exclamationMarek/skeuomorphicer_candle/README.md

# Skeuomorphicer Candle
thumbnail_candle
A more skeuomorphic LED candle, one that you turn on with a flame, and off with a blow, like a real candle!
Super simple design with no microcontrollers, op-amps nor any other integrated circuits. Just one transistor, one thermistor and a couple of passives.

As seen on youtube, here: [https://www.youtube.com/watch?v=r8O8MNvkZiY](https://www.youtube.com/watch?v=r8O8MNvkZiY)

# How it works
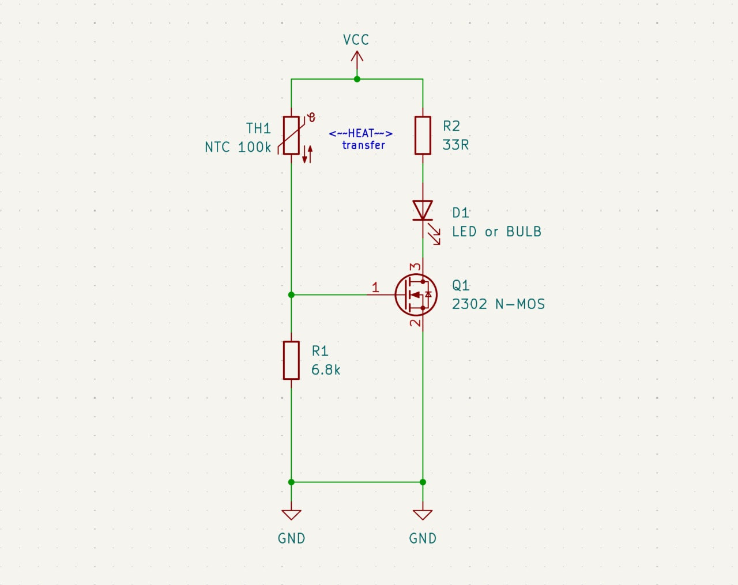
[picture p1: images/simplified_schematic.jpg]

* Heating the NTC thermistor makes its resistance drop, which increases the voltage on the MOSFET gate and turns on the bulb
* The current limiting R2 resistor gets hot
* The PCB is carefully designed to thermally connect R2 to the NTC
* Heat from R2 makes the NTC hot, so it stays hot even when the flame is removed
* This keeps the candle on
* Once you blow on the PCB, the heat is removed, breaking the cycle and turning off the light
* Yes, the schematic looks like a candle

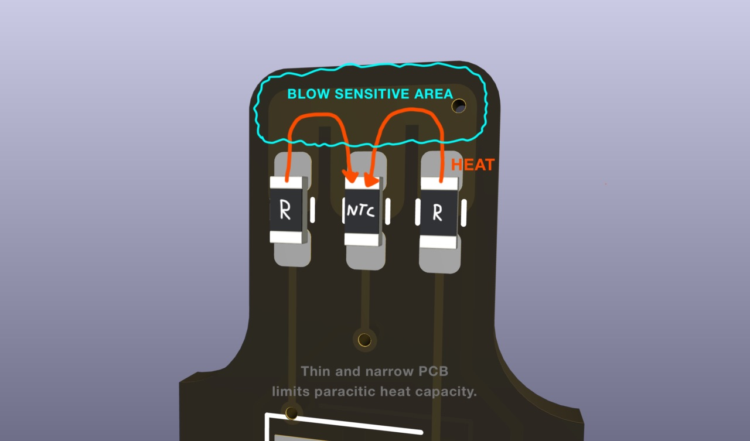
[picture p2: images/wick_design.jpg]

* The current limiting (and heat producing) resistor is doubled, to surround the NTC on both sides
* They also share an electrical connection with the NTC - the VCC node (on top)
* That VCC copper connection is used to transfer heat from the resistors to the NTC
* But also, is wide and exposed to being blown at
* This is a finicky design challenge that required iterative fine tuning
* The current implementation works best with about 0.1W (total) dissipated on the heating resistors, which keeps the NTC at about 55°C
* Testd on a 1.0mm 2-layer PCB with 35um copper foil. Tested with black solder mask (it might make a difference?)

Note that this is the simplified schematic that omits the power supply. In real application, the varying voltage of batteries causes the circuit to be unreliable. With a full battery, the NTC runs too hot, making the candle difficult to blow out, and with a low battery it runs too cool, turning itself off unprompted. To fix this, the recommended design adds a voltage regulator (boost converter) to keep VCC stable and the candle reliable.

# PCB design available in 4 variants:
## [Minimal](Skeuomorphic_candle_minimal)
* Designed for 1.5V mini light bulb and 2xAA batteries
* Very low component count
* Does not work with LEDs!
* No ICs. Just 1 NMOS, 1 NTC and some resistors
* If you want the simplest skeuomorphicer candle, use this PCB.
* Alternatively, use with external 3.3V regulated supply

## [Basic - recommended](Skeuomorphic_candle_basic)
* Works great with a mini light bulb and OK-ish with LEDs
* Supports various batteries
* Low component count, but requires power regulator IC
* If you want to make a resonably well working skeuomorphicer candle, use this PCB

## [Custom](Skeuomorphic_candle_custom)
* PCB with extra footprints for implementation flexibility
* Can be configured as either the "Minimal" or "Basic" variant
* Can be configured as bulb + LEDs
* LED brightness can be adjusted, while maintaining reliable flame detection
* Has test points
* If you want to experiment with the design, use this PCB

## [Digital](Skeuomorphic_candle_digital)
* EWWWW digital microcontroller!
* 32bits?! For like one 'if' statement?!
* 2KB of RAM?! You can fly to the bloody moon on 2KB of RAM!
* If you're one of those futuristic cyberpunk chooms, use this PCB. I will try not to cry.

Detailed configuration and assembly instructions are in each PCB variant folder.

# License
This project is published under the [Creative Commons Attribution-NonCommercial 4.0 License](https://creativecommons.org/licenses/by-nc/4.0/deed.en)

Full text in license.txt

A commertial use license may be provided upon request
