exclamationMarek/skeuomorphicer_candle/Skeuomorphic_candle_custom/README.md

# Custom Skeuomorphicer Candle
For when you want to experiment with the design

# UNTESTED!
As of releasing this repo, this PCB design is NOT TESTED. It might be all wrong.
