exclamationMarek/skeuomorphicer_candle/Skeuomorphic_candle_minimal/Skeuomorphic_candle_minimal.kicad_pcb

## KiCad design Skeuomorphic_candle_minimal/Skeuomorphic_candle_minimal.kicad_pcb (2026-10-23)

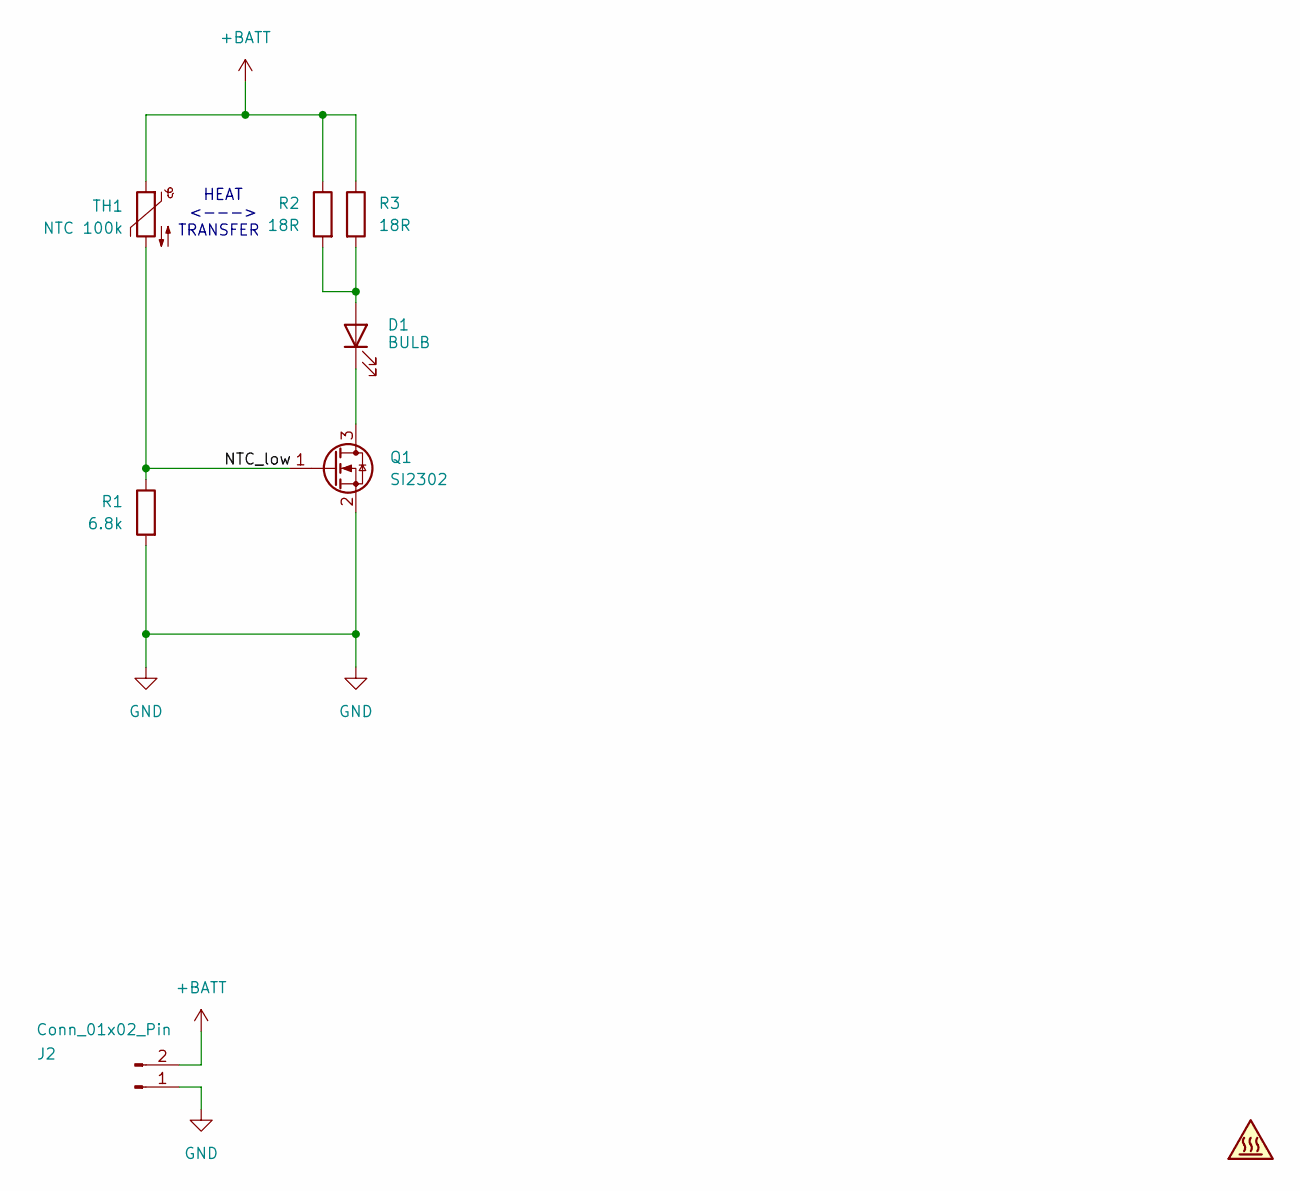
[picture p3: schematic Skeuomorphic_candle_minimal.kicad_sch, Skeuomorphicer Candle Minimal]

Parts:
D1: BULB; Mini_bulb_flat
J2: Conn_01x02_Pin; PinHeader_1x02_P2.54mm_Vertical
LOGO1: Logo; Skeuomorphicer_candle_logo
Q1: SI2302; SOT-23-handsoldering-smaller
R1: 6.8k; R_0603_1608Metric_Pad0.98x0.95mm_HandSolder
R2, R3: 18R; R_0603_1608Metric_Pad0.98x0.95mm_HandSolder
TH1: NTC 100k; R_0603_1608Metric_Pad0.98x0.95mm_HandSolder

Connections:
+BATT: J2.2, R2.1, R3.1, TH1.1
/NTC_low: Q1.1 (G), R1.1, TH1.2
GND: J2.1, Q1.2 (S), R1.2
unnamed: D1.2 (A), R2.2, R3.2
unnamed: D1.1 (K), Q1.3 (D)

Notes on the sheet:
HEAT <---> TRANSFER

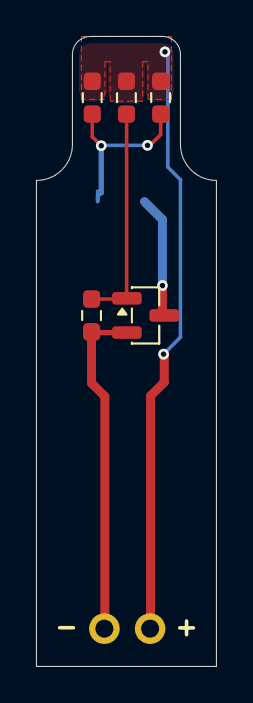
[picture p4: board Skeuomorphic_candle_minimal.kicad_pcb from above]

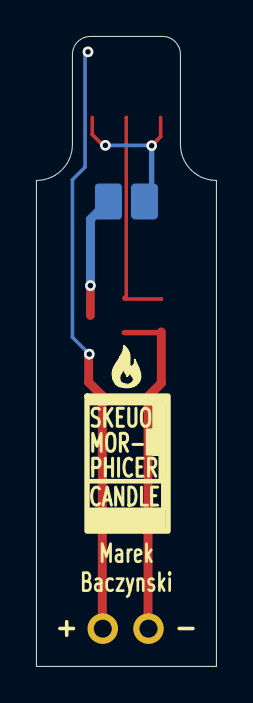
[picture p5: board Skeuomorphic_candle_minimal.kicad_pcb from below]

Board: 2 copper layers, 10.0 x 35.0 mm, 8 parts (2 on the bottom side), 5 nets.
