exclamationMarek/skeuomorphicer_candle/Skeuomorphic_candle_digital/Skeuomorphic_candle_digital.kicad_pcb

## KiCad design Skeuomorphic_candle_digital/Skeuomorphic_candle_digital.kicad_pcb (2026-10-23)

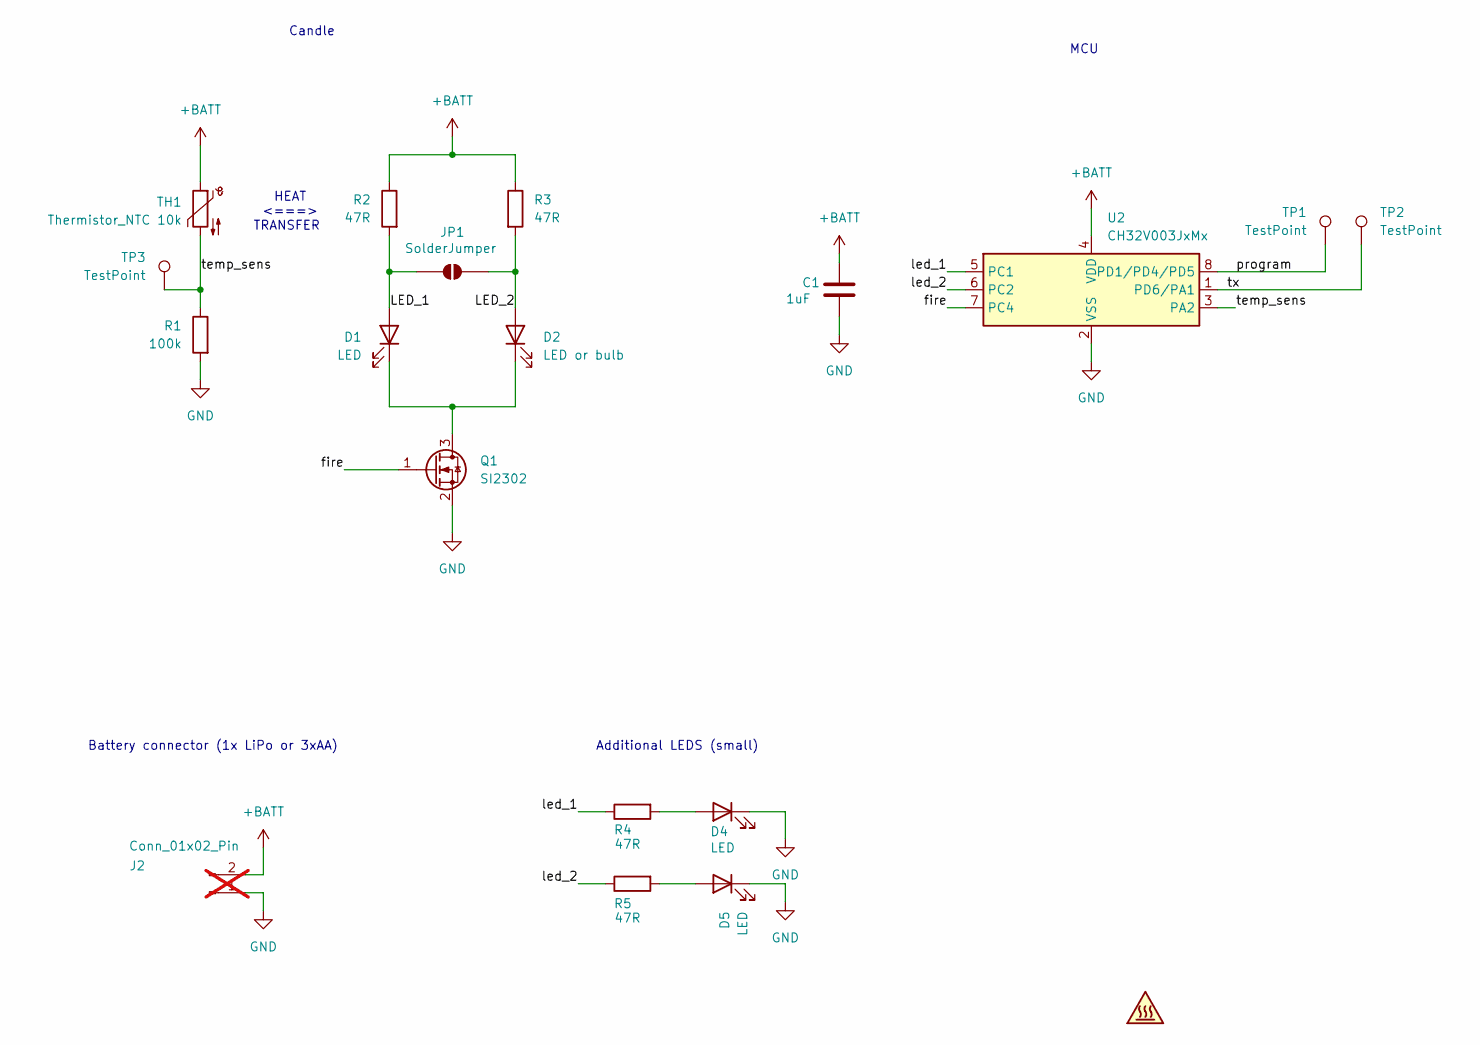
[picture p6: schematic Skeuomorphic_candle_digital.kicad_sch, Skeuomorphicer Candle - Digital]

Parts:
C1: 1uF; C_0603_1608Metric_Pad1.08x0.95mm_HandSolder
D1: LED; LED_PLCC_2835_Handsoldering
D2: LED or bulb; LED_PLCC_2835_Handsoldering
D4, D5: LED; LED_0603_1608Metric_Pad1.05x0.95mm_HandSolder
J2: Conn_01x02_Pin; PinHeader_1x02_P2.54mm_Vertical; not fitted
JP1: SolderJumper; SolderJumper-2_P1.3mm_Open_RoundedPad1.0x1.5mm
LOGO1: Logo; Skeuomorphicer_candle_logo
Q1: SI2302; SOT-23-handsoldering-smaller
R1: 100k; R_0603_1608Metric_Pad0.98x0.95mm_HandSolder
R2, R3, R4, R5: 47R; R_0603_1608Metric_Pad0.98x0.95mm_HandSolder
TH1: Thermistor_NTC 10k; R_0603_1608Metric_Pad0.98x0.95mm_HandSolder
TP1, TP2, TP3: TestPoint; TestPoint_Pad_D1.0mm
U2: CH32V003JxMx; JEITA_SOIC-8_3.9x4.9mm_P1.27mm

Connections:
+BATT: C1.1, J2.2, R2.1, R3.1, TH1.1, U2.4 (VDD)
/LED_1: D1.2 (A), JP1.1 (A), R2.2
/LED_2: D2.2 (A), JP1.2 (B), R3.2
/fire: Q1.1 (G), U2.7 (PC4)
/led_1: R4.1, U2.5 (PC1)
/led_2: R5.1, U2.6 (PC2)
/program: TP1.1 (1_1), U2.8 (PD1/PD4/PD5)
/temp_sens: R1.1, TH1.2, TP3.1 (1_1), U2.3 (PA2)
/tx: TP2.1 (1_1), U2.1 (PD6/PA1)
GND: C1.2, D4.1 (K), D5.1 (K), J2.1, Q1.2 (S), R1.2, U2.2 (VSS)
unnamed: D1.1 (K), D2.1 (K), Q1.3 (D)
unnamed: D4.2 (A), R4.2
unnamed: D5.2 (A), R5.2

Notes on the sheet:
MCU
Battery connector (1x LiPo or 3xAA)
HEAT <===> TRANSFER
Additional LEDS (small)
Candle

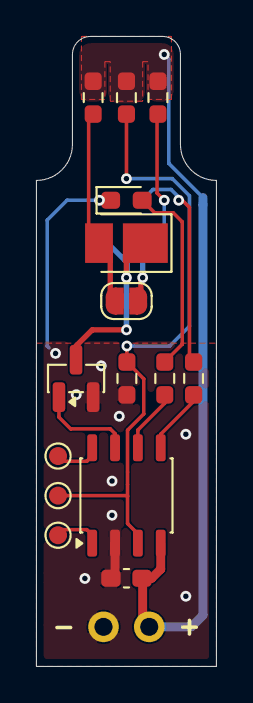
[picture p7: board Skeuomorphic_candle_digital.kicad_pcb from above]

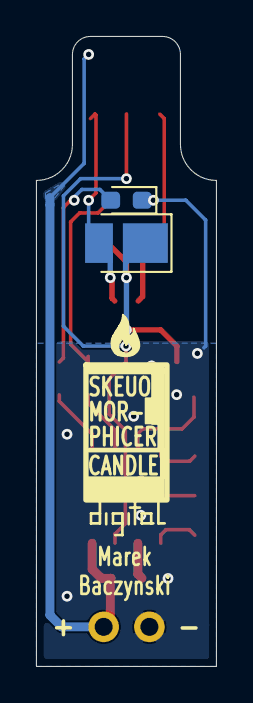
[picture p8: board Skeuomorphic_candle_digital.kicad_pcb from below]

Board: 2 copper layers, 10.0 x 35.0 mm, 19 parts (3 on the bottom side), 13 nets.
