exclamationMarek/skeuomorphicer_candle/Skeuomorphic_candle_basic/Skeuomorphic_candle_basic.kicad_pcb

## KiCad design Skeuomorphic_candle_basic/Skeuomorphic_candle_basic.kicad_pcb (2026-10-23)

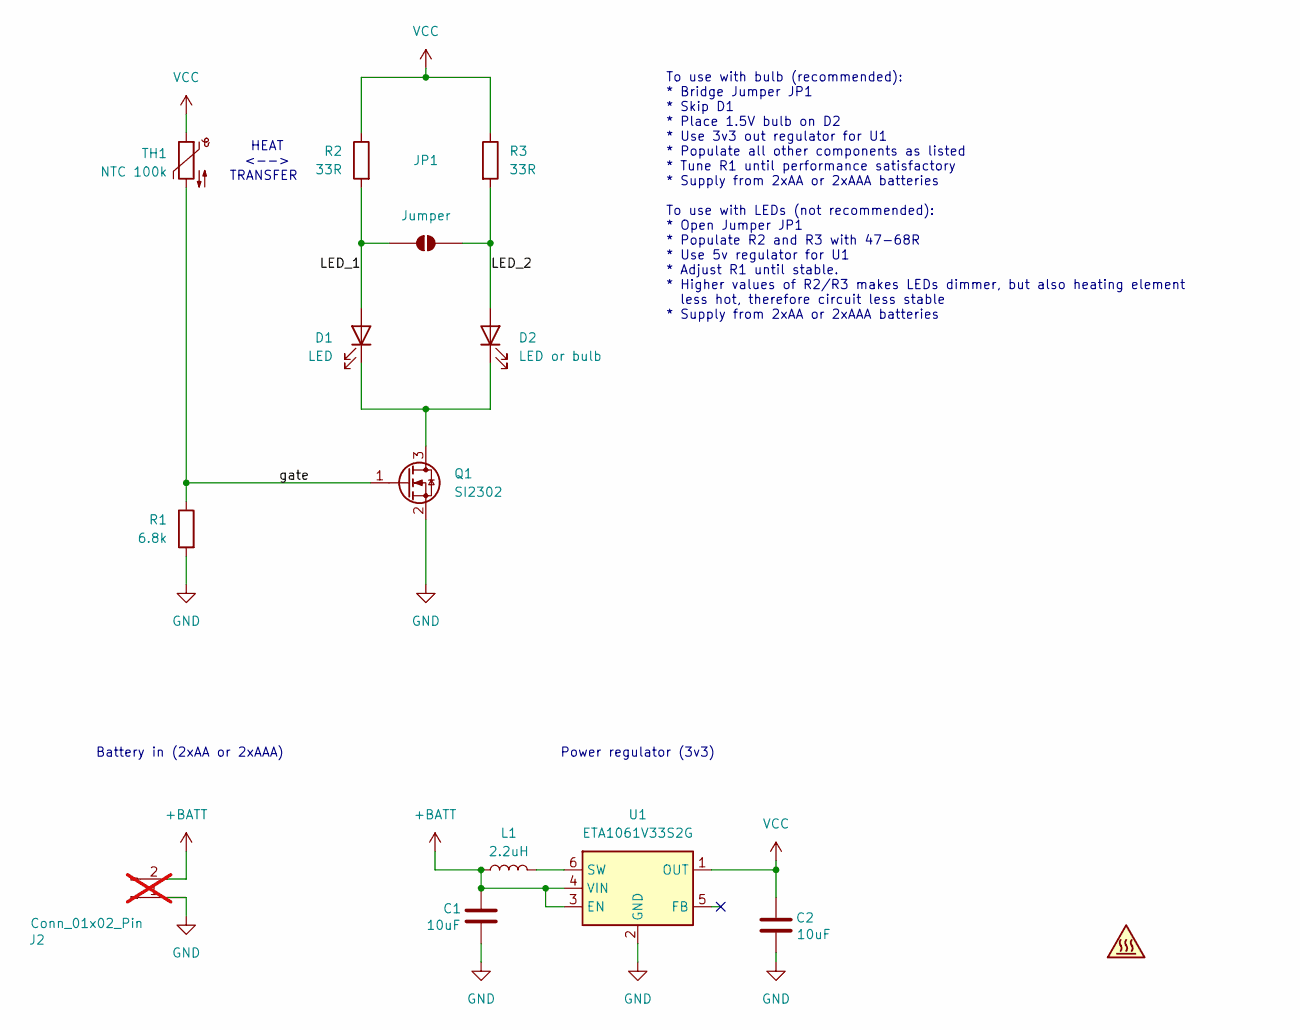
[picture p9: schematic Skeuomorphic_candle_basic.kicad_sch, Skeuomorphicer Candle Basic]

Parts:
C1, C2: 10uF; C_0603_1608Metric_Pad1.08x0.95mm_HandSolder
D1: LED; LED_PLCC_2835_Handsoldering
D2: LED or bulb; LED_PLCC_2835_Handsoldering
J2: Conn_01x02_Pin; PinHeader_1x02_P2.54mm_Vertical; not fitted
JP1: Jumper; SolderJumper-2_P1.3mm_Open_RoundedPad1.0x1.5mm
L1: 2.2uH; L_1008_2520Metric_Pad1.43x2.20mm_HandSolder; MPN WIP252012P-2R2ML
LOGO1: Logo; Skeuomorphicer_candle_logo
Q1: SI2302; SOT-23-handsoldering-smaller
R1: 6.8k; R_0603_1608Metric_Pad0.98x0.95mm_HandSolder
R2, R3: 33R; R_0603_1608Metric_Pad0.98x0.95mm_HandSolder
TH1: NTC 100k; R_0603_1608Metric_Pad0.98x0.95mm_HandSolder
U1: ETA1061V33S2G; SOT-23-6

Connections:
+BATT: C1.1, J2.2, L1.1, U1.3 (EN), U1.4 (VIN)
/LED_1: D1.2 (A), JP1.1 (A), R2.2
/LED_2: D2.2 (A), JP1.2 (B), R3.2
/gate: Q1.1 (G), R1.1, TH1.2
GND: C1.2, C2.2, J2.1, Q1.2 (S), R1.2, U1.2 (GND)
unnamed: D1.1 (K), D2.1 (K), Q1.3 (D)
unnamed: L1.2, U1.6 (SW)
VCC: C2.1, R2.1, R3.1, TH1.1, U1.1 (OUT)

Notes on the sheet:
To use with bulb (recommended): * Bridge Jumper JP1 * Skip D1 * Place 1.5V bulb on D2 * Use 3v3 out regulator for U1 * Populate all other components as listed * Tune R1 until performance satisfactory * Supply from 2xAA or 2xAAA batteries To use with LEDs (not recommended): * Open Jumper JP1 * Popul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
HEAT <--> TRANSFER
Battery in (2xAA or 2xAAA)
Power regulator (3v3)

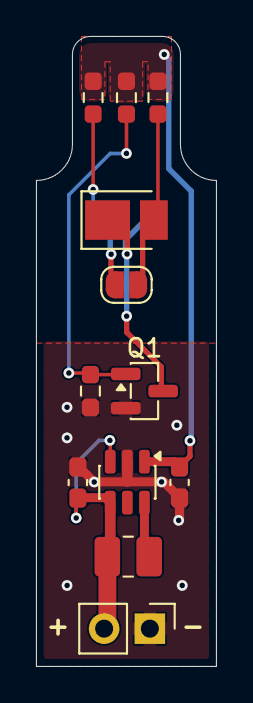
[picture p10: board Skeuomorphic_candle_basic.kicad_pcb from above]

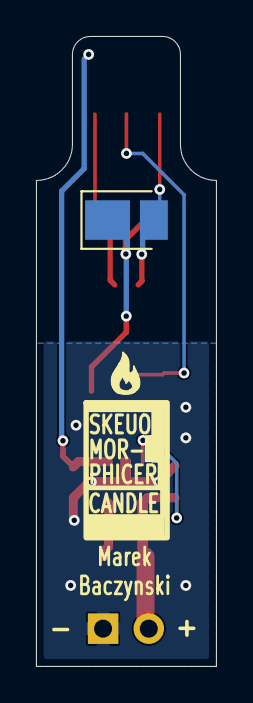
[picture p11: board Skeuomorphic_candle_basic.kicad_pcb from below]

Board: 2 copper layers, 10.0 x 35.0 mm, 14 parts (2 on the bottom side), 8 nets.
