exclamationMarek/skeuomorphicer_candle/Skeuomorphic_candle_custom/Skeuomorphic_candle_custom.kicad_pcb

## KiCad design Skeuomorphic_candle_custom/Skeuomorphic_candle_custom.kicad_pcb (2026-10-23)

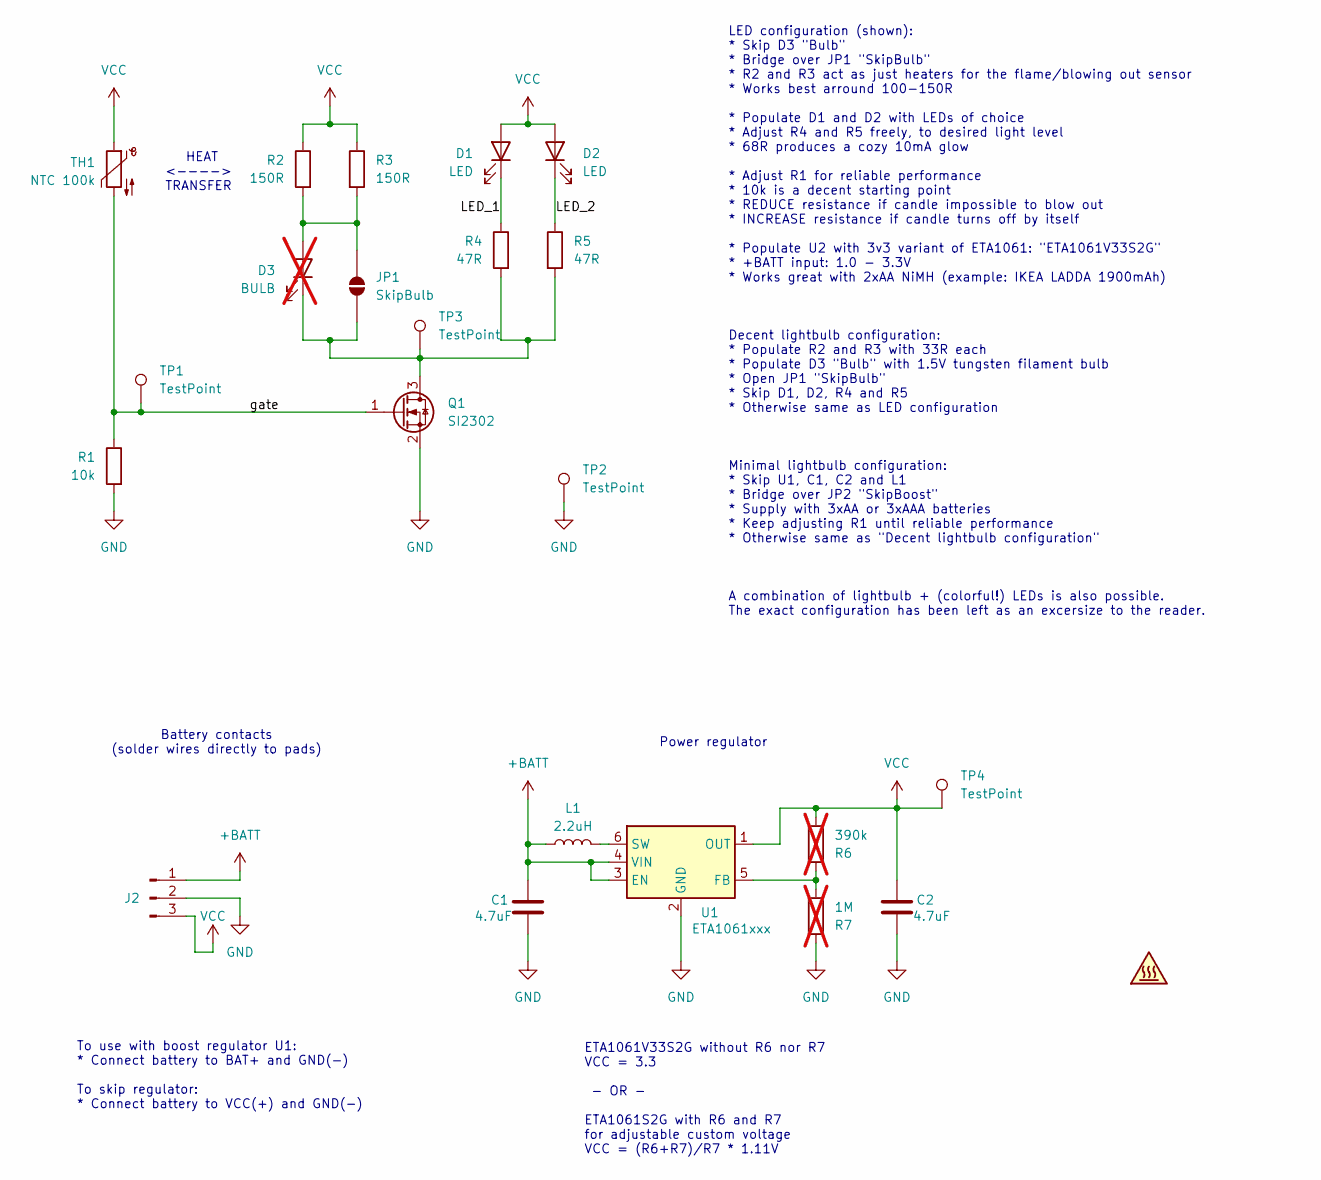
[picture p12: schematic Skeuomorphic_candle_custom.kicad_sch, Skeuomorphic Candle - Customizable]

Parts:
C1, C2: 4.7uF; C_0603_1608Metric_Pad1.08x0.95mm_HandSolder
D1, D2: LED; LED_PLCC_2835_Handsoldering
D3: BULB; Mini_bulb_flat; not fitted
J2: Conn_01x03_Pin; PinHeader_1x03_P2.54mm_Vertical
JP1: SkipBulb; SolderJumper-2_P1.3mm_Open_RoundedPad1.0x1.5mm
L1: 2.2uH; L_1008_2520Metric_Pad1.43x2.20mm_HandSolder; MPN INPAQ WIP252012P-2R2ML
LOGO1: Logo; Skeuomorphicer_candle_logo
Q1: SI2302; SOT-23-handsoldering-smaller
R1: 10k; R_0603_1608Metric_Pad0.98x0.95mm_HandSolder
R2, R3: 150R; R_0603_1608Metric_Pad0.98x0.95mm_HandSolder
R4, R5: 47R; R_0603_1608Metric_Pad0.98x0.95mm_HandSolder
R6: 390k; R_0603_1608Metric_Pad0.98x0.95mm_HandSolder; not fitted
R7: 1M; R_0603_1608Metric_Pad0.98x0.95mm_HandSolder; not fitted
TH1: NTC 100k; R_0603_1608Metric_Pad0.98x0.95mm_HandSolder
TP1, TP2, TP3, TP4: TestPoint; TestPoint_Pad_D1.0mm
U1: ETA1061xxx; SOT-23-6; MPN ETA1061V33S2G

Connections:
+BATT: C1.1, J2.1, L1.1, U1.3 (EN), U1.4 (VIN)
/LED_1: D1.1 (K), R4.1
/LED_2: D2.1 (K), R5.1
/gate: Q1.1 (G), R1.1, TH1.2, TP1.1 (1_1)
GND: C1.2, C2.2, J2.2, Q1.2 (S), R1.2, R7.1, TP2.1 (1_1), U1.2 (GND)
unnamed: D3.2 (A), JP1.2 (B), R2.2, R3.2
unnamed: D3.1 (K), JP1.1 (A), Q1.3 (D), R4.2, R5.2, TP3.1 (1_1)
unnamed: R6.1, R7.2, U1.5 (FB)
unnamed: L1.2, U1.6 (SW)
VCC: C2.1, D1.2 (A), D2.2 (A), J2.3, R2.1, R3.1, R6.2, TH1.1, TP4.1 (1_1), U1.1 (OUT)

Notes on the sheet:
Battery contacts (solder wires directly to pads)
To use with boost regulator U1: * Connect battery to BAT+ and GND(-) To skip regulator: * Connect battery to VCC(+) and GND(-)
Power regulator
ETA1061V33S2G without R6 nor R7 VCC = 3.3 - OR - ETA1061S2G with R6 and R7 for adjustable custom voltage VCC = (R6+R7)/R7 * 1.11V
LED configuration (shown): * Skip D3 "Bulb" * Bridge over JP1 "SkipBulb" * R2 and R3 act as just heaters for the flame/blowing out sensor * Works best arround 100-150R * Populate D1 and D2 with LEDs of choice * Adjust R4 and R5 freely, to desired light level * 68R produces a cozy 10mA glow * Adjust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
HEAT <----> TRANSFER

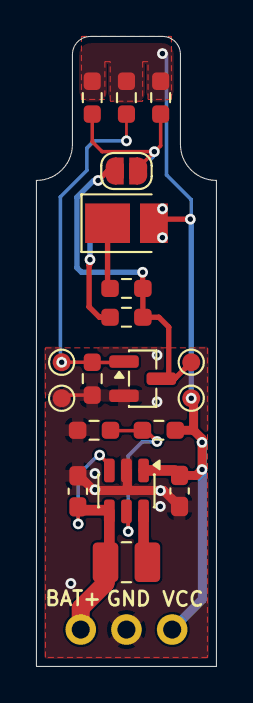
[picture p13: board Skeuomorphic_candle_custom.kicad_pcb from above]

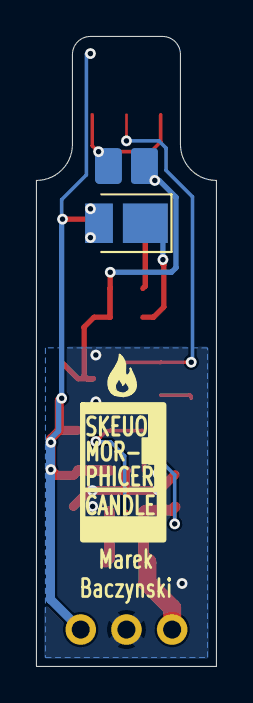
[picture p14: board Skeuomorphic_candle_custom.kicad_pcb from below]

Board: 2 copper layers, 10.0 x 35.0 mm, 23 parts (3 on the bottom side), 10 nets.
