exclamationMarek/skeuomorphicer_candle/(commit log)

2026-10-23 Added the PCBs
2026-10-23 added readme per pcb variant. fixed some component values
